raigandhiayush/tomasulo-rv/ooo_fpga/top_fpga_ooo.xdc

## 100 MHz clock; the 50 MHz core clock is derived by the MMCM (D7) automatically
set_property -dict { PACKAGE_PIN E3    IOSTANDARD LVCMOS33 } [get_ports { clk }]
create_clock -add -name sys_clk_pin -period 10.00 -waveform {0 5} [get_ports { clk }]

## reset: CPU_RESETN button
set_property -dict { PACKAGE_PIN C12   IOSTANDARD LVCMOS33 } [get_ports { reset }]

## boot loader: BTNC (N17), active high; hold it while releasing CPU_RESET (uart_loader.v)
set_property -dict { PACKAGE_PIN N17   IOSTANDARD LVCMOS33 } [get_ports { load_btn }]

## buttons, read by software at 0x1000_000C (btn[0]=BTNU, [1]=BTND, [2]=BTNL, [3]=BTNR)
set_property -dict { PACKAGE_PIN M18   IOSTANDARD LVCMOS33 } [get_ports { btn[0] }]
set_property -dict { PACKAGE_PIN P18   IOSTANDARD LVCMOS33 } [get_ports { btn[1] }]
set_property -dict { PACKAGE_PIN P17   IOSTANDARD LVCMOS33 } [get_ports { btn[2] }]
set_property -dict { PACKAGE_PIN M17   IOSTANDARD LVCMOS33 } [get_ports { btn[3] }]

## switches (SW8/SW9 sit in a 1.8 V bank)
set_property -dict { PACKAGE_PIN J15   IOSTANDARD LVCMOS33 } [get_ports { sw[0] }]
set_property -dict { PACKAGE_PIN L16   IOSTANDARD LVCMOS33 } [get_ports { sw[1] }]
set_property -dict { PACKAGE_PIN M13   IOSTANDARD LVCMOS33 } [get_ports { sw[2] }]
set_property -dict { PACKAGE_PIN R15   IOSTANDARD LVCMOS33 } [get_ports { sw[3] }]
set_property -dict { PACKAGE_PIN R17   IOSTANDARD LVCMOS33 } [get_ports { sw[4] }]
set_property -dict { PACKAGE_PIN T18   IOSTANDARD LVCMOS33 } [get_ports { sw[5] }]
set_property -dict { PACKAGE_PIN U18   IOSTANDARD LVCMOS33 } [get_ports { sw[6] }]
set_property -dict { PACKAGE_PIN R13   IOSTANDARD LVCMOS33 } [get_ports { sw[7] }]
set_property -dict { PACKAGE_PIN T8    IOSTANDARD LVCMOS18 } [get_ports { sw[8] }]
set_property -dict { PACKAGE_PIN U8    IOSTANDARD LVCMOS18 } [get_ports { sw[9] }]
set_property -dict { PACKAGE_PIN R16   IOSTANDARD LVCMOS33 } [get_ports { sw[10] }]
set_property -dict { PACKAGE_PIN T13   IOSTANDARD LVCMOS33 } [get_ports { sw[11] }]
set_property -dict { PACKAGE_PIN H6    IOSTANDARD LVCMOS33 } [get_ports { sw[12] }]
set_property -dict { PACKAGE_PIN U12   IOSTANDARD LVCMOS33 } [get_ports { sw[13] }]
set_property -dict { PACKAGE_PIN U11   IOSTANDARD LVCMOS33 } [get_ports { sw[14] }]
set_property -dict { PACKAGE_PIN V10   IOSTANDARD LVCMOS33 } [get_ports { sw[15] }]

## LEDs: led[15] done, led[14] exception, led[13:0] result[13:0]
set_property -dict { PACKAGE_PIN H17   IOSTANDARD LVCMOS33 } [get_ports { led[0] }]
set_property -dict { PACKAGE_PIN K15   IOSTANDARD LVCMOS33 } [get_ports { led[1] }]
set_property -dict { PACKAGE_PIN J13   IOSTANDARD LVCMOS33 } [get_ports { led[2] }]
set_property -dict { PACKAGE_PIN N14   IOSTANDARD LVCMOS33 } [get_ports { led[3] }]
set_property -dict { PACKAGE_PIN R18   IOSTANDARD LVCMOS33 } [get_ports { led[4] }]
set_property -dict { PACKAGE_PIN V17   IOSTANDARD LVCMOS33 } [get_ports { led[5] }]
set_property -dict { PACKAGE_PIN U17   IOSTANDARD LVCMOS33 } [get_ports { led[6] }]
set_property -dict { PACKAGE_PIN U16   IOSTANDARD LVCMOS33 } [get_ports { led[7] }]
set_property -dict { PACKAGE_PIN V16   IOSTANDARD LVCMOS33 } [get_ports { led[8] }]
set_property -dict { PACKAGE_PIN T15   IOSTANDARD LVCMOS33 } [get_ports { led[9] }]
set_property -dict { PACKAGE_PIN U14   IOSTANDARD LVCMOS33 } [get_ports { led[10] }]
set_property -dict { PACKAGE_PIN T16   IOSTANDARD LVCMOS33 } [get_ports { led[11] }]
set_property -dict { PACKAGE_PIN V15   IOSTANDARD LVCMOS33 } [get_ports { led[12] }]
set_property -dict { PACKAGE_PIN V14   IOSTANDARD LVCMOS33 } [get_ports { led[13] }]
set_property -dict { PACKAGE_PIN V12   IOSTANDARD LVCMOS33 } [get_ports { led[14] }]
set_property -dict { PACKAGE_PIN V11   IOSTANDARD LVCMOS33 } [get_ports { led[15] }]

## 7-segment display: seg = {DP, CG, CF, CE, CD, CC, CB, CA}, an[7:0]; all active low
set_property -dict { PACKAGE_PIN T10   IOSTANDARD LVCMOS33 } [get_ports { seg[0] }]
set_property -dict { PACKAGE_PIN R10   IOSTANDARD LVCMOS33 } [get_ports { seg[1] }]
set_property -dict { PACKAGE_PIN K16   IOSTANDARD LVCMOS33 } [get_ports { seg[2] }]
set_property -dict { PACKAGE_PIN K13   IOSTANDARD LVCMOS33 } [get_ports { seg[3] }]
set_property -dict { PACKAGE_PIN P15   IOSTANDARD LVCMOS33 } [get_ports { seg[4] }]
set_property -dict { PACKAGE_PIN T11   IOSTANDARD LVCMOS33 } [get_ports { seg[5] }]
set_property -dict { PACKAGE_PIN L18   IOSTANDARD LVCMOS33 } [get_ports { seg[6] }]
set_property -dict { PACKAGE_PIN H15   IOSTANDARD LVCMOS33 } [get_ports { seg[7] }]
set_property -dict { PACKAGE_PIN J17   IOSTANDARD LVCMOS33 } [get_ports { an[0] }]
set_property -dict { PACKAGE_PIN J18   IOSTANDARD LVCMOS33 } [get_ports { an[1] }]
set_property -dict { PACKAGE_PIN T9    IOSTANDARD LVCMOS33 } [get_ports { an[2] }]
set_property -dict { PACKAGE_PIN J14   IOSTANDARD LVCMOS33 } [get_ports { an[3] }]
set_property -dict { PACKAGE_PIN P14   IOSTANDARD LVCMOS33 } [get_ports { an[4] }]
set_property -dict { PACKAGE_PIN T14   IOSTANDARD LVCMOS33 } [get_ports { an[5] }]
set_property -dict { PACKAGE_PIN K2    IOSTANDARD LVCMOS33 } [get_ports { an[6] }]
set_property -dict { PACKAGE_PIN U13   IOSTANDARD LVCMOS33 } [get_ports { an[7] }]

## USB-UART bridge, pins from Digilent's master file (UART_TXD_IN, UART_RXD_OUT): C4 is the
## FPGA's input, D4 its output
set_property -dict { PACKAGE_PIN C4    IOSTANDARD LVCMOS33 } [get_ports { uart_rx }]
set_property -dict { PACKAGE_PIN D4    IOSTANDARD LVCMOS33 } [get_ports { uart_tx }]

## asynchronous inputs go through synchronizers in the RTL; human-speed outputs
set_false_path -from [get_ports { reset sw[*] uart_rx }]
set_false_path -to   [get_ports { led[*] seg[*] an[*] uart_tx }]

## Configuration bank voltage (Digilent master file); avoids the CFGBVS DRC warning at write_bitstream
set_property CFGBVS VCCO [current_design]
set_property CONFIG_VOLTAGE 3.3 [current_design]
