raigandhiayush/tomasulo-rv/baseline_fpga/constraints.xdc

################ CLOCK ################
set_property PACKAGE_PIN E3 [get_ports clk]
set_property IOSTANDARD LVCMOS33 [get_ports clk]
create_clock -period 10.000 [get_ports clk]

################ RESET ################
set_property PACKAGE_PIN J15 [get_ports reset]
set_property IOSTANDARD LVCMOS33 [get_ports reset]
set_property PULLDOWN true [get_ports reset]

################ LEDS #################
# LEDs LD0-LD15
set_property PACKAGE_PIN H17 [get_ports {led[0]}]
set_property PACKAGE_PIN K15 [get_ports {led[1]}]
set_property PACKAGE_PIN J13 [get_ports {led[2]}]
set_property PACKAGE_PIN N14 [get_ports {led[3]}]
set_property PACKAGE_PIN R18 [get_ports {led[4]}]
set_property PACKAGE_PIN V17 [get_ports {led[5]}]
set_property PACKAGE_PIN U17 [get_ports {led[6]}]
set_property PACKAGE_PIN U16 [get_ports {led[7]}]
set_property PACKAGE_PIN V16 [get_ports {led[8]}]
set_property PACKAGE_PIN T15 [get_ports {led[9]}]
set_property PACKAGE_PIN U14 [get_ports {led[10]}]
set_property PACKAGE_PIN T16 [get_ports {led[11]}]
set_property PACKAGE_PIN V15 [get_ports {led[12]}]
set_property PACKAGE_PIN V14 [get_ports {led[13]}]
set_property PACKAGE_PIN V12 [get_ports {led[14]}]
set_property PACKAGE_PIN V11 [get_ports {led[15]}]

set_property IOSTANDARD LVCMOS33 [get_ports led[*]]
