raigandhiayush/tomasulo-rv/baseline_m/execute_m.v

`timescale 1ns/1ps
// Execution stage for pipe_m supporting ALU operations and in-order MUL/DIV freeze.

////////////////////////////////////////////////////////////// Stage 2: Execute////////////////////////////////////////////////////////////
module execute_m
#(
	parameter [31:0] RESET = 32'h0000_0000
)
(
	input clk,
	input reset,

	// -----------------------------	// FROM ID/EX	// -----------------------------
	input  [31:0] reg_rdata1,
	input  [31:0] reg_rdata2,
	input  [31:0] execute_imm,
	input  [31:0] pc,
	input  [31:0] fetch_pc,
	input     	immediate_sel,
	input     	mem_write,
	input     	jal,
	input     	jalr,
	input     	lui,
	input     	alu,
	input     	branch,
	input     	muldiv,
	input     	arithsubtype,
	input     	mem_to_reg,
	input     	stall_read,

	input  [4:0]  dest_reg_sel,
	input  [2:0]  alu_op,
	input  [1:0]  dmem_raddr,

	// -----------------------------	// FROM WB	// -----------------------------
	input     	wb_branch_i,
	input     	wb_branch_nxt_i,

	// -----------------------------	// EX → PIPE	// -----------------------------
	output [31:0] alu_operand1,
	output [31:0] alu_operand2,
	output [31:0] write_address,
	output    	branch_stall,
	output    	md_freeze,

	output reg [31:0] next_pc,
	output reg    	branch_taken,

	// -----------------------------  // EX → WB	// -----------------------------
	output [31:0] wb_result,
	output    	wb_mem_write,
	output    	wb_alu_to_reg,
	output [4:0]  wb_dest_reg_sel,
	output    	wb_branch,
	output    	wb_branch_nxt,
	output    	wb_mem_to_reg,
	output [1:0]  wb_read_address,
	output [2:0]  mem_alu_operation
);

//////////////// Including OPCODES ////////////////////////////
`include "opcode.vh"
`include "ooo_defs.vh"

////////////////////////////////////////////////////////////// LOCAL INTERNAL SIGNALS/////////////////////////////////

reg  [31:0] ex_result;
wire [32:0] ex_result_subs;
wire [32:0] ex_result_subu;

////////////////////////////////////////////////////////////// Operand selection///////////////////////////////////////////////////////

// Select ALU operands from register file or immediate.

assign alu_operand1 = reg_rdata1;
assign alu_operand2 = immediate_sel
                    	? execute_imm:reg_rdata2;

////////////////////////////////////////////////////////////// Subtractions////////////////////////////////////////////////////////////


// Signed and unsigned subtraction results for branch comparisons.

assign ex_result_subs =
	{alu_operand1[31], alu_operand1} -
	{alu_operand2[31], alu_operand2};

assign ex_result_subu = {1'b0,alu_operand1}-{1'b0,alu_operand2};

// SRA/SRAI on its own wire: inside ?: next to the unsigned SRL operand, Verilog
// evaluates >>> unsigned, i.e. as a logical shift (the baseline execute.v bug).
// Shift amounts use bits [4:0] only (RISC-V spec, baseline finding F5).
wire [31:0] sra_result = $signed(alu_operand1) >>> alu_operand2[4:0];

////////////////////////////////////////////////////////////// Address & branch stall////////////////////////////////////////

assign write_address = alu_operand1 + execute_imm;
assign branch_stall  = wb_branch_nxt_i || wb_branch_i;

////////////////////////////////////////////////////////////// MUL/DIV (in order, pipeline frozen)//////////////////////////////////

wire        md_valid = muldiv && !branch_stall;
wire        is_div   = alu_op[2];			// funct3 1xx: DIV, DIVU, REM, REMU
reg         md_busy;					// unit started, result not yet back
wire        md_start = md_valid && !md_busy;
wire        mul_done, div_done;
wire [31:0] mul_result, div_result;
wire        md_done  = mul_done || div_done;
wire [31:0] md_result = mul_done ? mul_result : div_result;

assign md_freeze = md_valid && !md_done;

always @(posedge clk or negedge reset) begin
	if (!reset)
    	md_busy <= 1'b0;
	else if (md_done)
    	md_busy <= 1'b0;
	else if (md_start)
    	md_busy <= 1'b1;
end

mul_unit u_mul (
	.clk     	(clk),
	.reset_n 	(reset),
	.start   	(md_start && !is_div),
	.funct3  	(alu_op[`OP_MD_HI:0]),
	.a       	(alu_operand1),
	.b       	(alu_operand2),
	.tag     	({`ROB_W{1'b0}}),
	.done    	(mul_done),
	.done_tag	(),
	.result  	(mul_result)
);

div_unit u_div (
	.clk     	(clk),
	.reset_n 	(reset),
	.start   	(md_start && is_div),
	.funct3  	(alu_op[`OP_MD_HI:0]),
	.a       	(alu_operand1),
	.b       	(alu_operand2),
	.tag     	({`ROB_W{1'b0}}),
	.busy    	(),
	.done    	(div_done),
	.result  	(div_result),
	.done_tag	()
);

////////////////////////////////////////////////////////////// Next PC logic////////////////////////////////////////////////////////////


// Compute next PC and resolve branch/jump targets.

always @(*) begin
	next_pc  	= fetch_pc + 4;
	branch_taken = !branch_stall;

	case (1'b1)
    	jal  : next_pc = pc + execute_imm;
    	jalr : next_pc = alu_operand1 + execute_imm;

    	branch: begin
        	case (alu_op)
            	BEQ:  begin
                	next_pc = (ex_result_subs == 0)
                          	? pc + execute_imm
                          	: fetch_pc + 4;
                	if (ex_result_subs != 0)
                    	branch_taken = 1'b0;
            	end
            	BNE:  begin
                	next_pc = (ex_result_subs != 0)
                          	? pc + execute_imm
                          	: fetch_pc + 4;
                	if (ex_result_subs == 0)
                    	branch_taken = 1'b0;
            	end
            	BLT:  begin
                	next_pc = ex_result_subs[32]
                          	? pc + execute_imm
                          	: fetch_pc + 4;
                	if (!ex_result_subs[32])
                    	branch_taken = 1'b0;
            	end
            	BGE:  begin
                	next_pc = (!ex_result_subs[32])
                          	? pc + execute_imm
                          	: fetch_pc + 4;
                	if (ex_result_subs[32] )
                    	branch_taken = 1'b0;
            	end
            	BLTU: begin
                	next_pc = ex_result_subu[32]
                          	? pc + execute_imm
                          	: fetch_pc + 4;
                	if (!ex_result_subu[32])
                    	branch_taken = 1'b0;
            	end
            	BGEU: begin
                	next_pc = (!ex_result_subu[32])
                          	? pc + execute_imm
                          	: fetch_pc + 4;
                	if (ex_result_subu[32] )
                    	branch_taken = 1'b0;
            	end
            	default: next_pc = fetch_pc + 4; // sequential execution
        	endcase
    	end

    	default: begin     	 
        	next_pc  	= fetch_pc + 4;
        	branch_taken = 1'b0;
    	end
	endcase
end

////////////////////////////////////////////////////////////// ALU result logic////////////////////////////////////////////////////////////

// Compute execute-stage result for ALU, control, and memory operations.


always @(*) begin
	case (1'b1)
    	mem_write: ex_result = alu_operand2;
    	muldiv:	ex_result = md_result;
    	jal,
    	jalr:  	ex_result = pc + 4;
    	lui:   	ex_result = execute_imm;

    	alu: begin
        	case (alu_op)
            	ADD : ex_result =
                  	arithsubtype
                  	? alu_operand1 - alu_operand2
                  	: alu_operand1 + alu_operand2;
            	SLL :ex_result = alu_operand1 << alu_operand2[4:0];
            	SLT : ex_result = ex_result_subs[32];
            	SLTU:ex_result = ex_result_subu[32];
            	XOR : ex_result = alu_operand1 ^ alu_operand2;
            	SR  : ex_result =
                  	arithsubtype
                  	? sra_result
                  	: alu_operand1 >> alu_operand2[4:0];
            	OR  : ex_result =alu_operand1 | alu_operand2;
            	AND : ex_result = alu_operand1 & alu_operand2;
            	default: ex_result = 'hx;
        	endcase
    	end

    	default: ex_result = 'hx;
	endcase
end


////////////////////////////////////////////////////////////// EX → WB pipeline register/////////////////////////////////////////

ex_mem_wb_reg_m u_ex_mem_wb (
	.clk        	(clk),
	.reset_n    	(reset),
	.stall_n    	(stall_read || md_freeze),

	.ex_result  	(ex_result),

	.mem_write  	(mem_write && !branch_stall),
	.alu_to_reg 	((alu | lui | jal |
                  	jalr | mem_to_reg) && !branch_stall),
	.dest_reg_sel   (dest_reg_sel),
	.branch_taken   (branch_taken),
	.mem_to_reg 	(mem_to_reg),
	.read_address   (dmem_raddr),
	.alu_operation  (alu_op),

	.ex_mem_result    	(wb_result),
	.ex_mem_mem_write 	(wb_mem_write),
	.ex_mem_alu_to_reg	(wb_alu_to_reg),
	.ex_mem_dest_reg_sel  (wb_dest_reg_sel),
	.ex_mem_branch    	(wb_branch),
	.ex_mem_branch_nxt	(wb_branch_nxt),
	.ex_mem_mem_to_reg	(wb_mem_to_reg),
	.ex_mem_read_address  (wb_read_address),
	.ex_mem_alu_operation (mem_alu_operation)
);

endmodule


module ex_mem_wb_reg_m (
	input     	clk,
	input     	reset_n,
	input     	stall_n,

	// Data
	input  [31:0] ex_result,

	// Control inputs from EX/MEM
	input     	mem_write,
	input     	alu_to_reg,
	input  [4:0]  dest_reg_sel,
	input     	branch_taken,
	input     	mem_to_reg,
	input  [1:0]  read_address,
	input  [2:0]  alu_operation,

	// Outputs to WB
	output reg [31:0] ex_mem_result,
	output reg    	ex_mem_mem_write,
	output reg    	ex_mem_alu_to_reg,
	output reg [4:0]  ex_mem_dest_reg_sel,
	output reg    	ex_mem_branch,
	output reg    	ex_mem_branch_nxt,
	output reg    	ex_mem_mem_to_reg,
	output reg [1:0]  ex_mem_read_address,
	output reg [2:0]  ex_mem_alu_operation
);

// EX/MEM to WB pipeline register.

always @(posedge clk or negedge reset_n) begin
	if (!reset_n) begin
    	ex_mem_result     	<= 32'h0;
    	ex_mem_mem_write  	<= 1'b0;
    	ex_mem_alu_to_reg 	<= 1'b0;
    	ex_mem_dest_reg_sel   <= 5'h0;
    	ex_mem_branch     	<= 1'b0;
    	ex_mem_branch_nxt 	<= 1'b0;
    	ex_mem_mem_to_reg 	<= 1'b0;
    	ex_mem_read_address   <= 2'h0;
    	ex_mem_alu_operation  <= 3'h0;
	end
	else if (!stall_n) begin  
    	ex_mem_result     	<= ex_result;
    	ex_mem_mem_write  	<= mem_write;
    	ex_mem_alu_to_reg 	<= alu_to_reg;
    	ex_mem_dest_reg_sel   <= dest_reg_sel;
    	ex_mem_branch     	<= branch_taken;
    	ex_mem_branch_nxt 	<= ex_mem_branch;   
    	ex_mem_mem_to_reg 	<= mem_to_reg;
    	ex_mem_read_address   <= read_address;
    	ex_mem_alu_operation  <= alu_operation;
	end
end

endmodule
