raigandhiayush/tomasulo-rv/(commit log)

2026-10-26 Add reference model, ELF checker and commit-trace test
2026-11-01 feat: add FPGA display paging and switch debounce
    Updated comments for clarity and added detailed information about the functionality of the module and its components.
2026-11-06 feat(uart): add 115200-baud UART with RX/TX FIFOs
2026-11-06 feat(top): add UART, button and cycle-counter MMIO and boot loader to top_fpga_ooo
2026-11-06 test(top): tie new UART/button inputs in tb_top_fpga_ooo
2026-11-06 test(trace): tie new UART/button inputs in tb_commit_trace
2026-11-06 test(programs): add mul_stream image and expected trace
2026-11-06 test(programs): add muldiv_stream image and expected trace
2026-11-06 test(uart): add UART echo input and expected output
2026-11-06 test(uart): add UART calculator program
2026-11-06 test(uart): add UART echo program
2026-11-06 test(uart): add UART calculator input and expected output
2026-11-06 test(uart): add live UART session program
2026-11-06 test(uart): add live UART session scripts for sim and board
2026-11-06 Added UART support to top_fpga_base module
    Added UART RX and TX signals to the top module.
2026-11-06 Update constraints for buttons and UART in XDC file
2026-11-06 Added button MMIO demo program
2026-11-06 added uart_loader
2026-11-07 Feat: added UI to show program trace
